ReuTheCoder/bolide-65-keeb/cad/readme.md

# CAD Notes

* To find the `.step` file for each individual component, look in the `production` folder.
    * Most 3D models came from KiCad's default libraries. Anythig else came from [GrabCAD](https://grabcad.com/library/cherry-mx-stabilizer-mx-1) or the [scottokeebs](https://github.com/joe-scotto/scottokeebs/tree/main/Extras/ScottoKicad/3dmodels) Github.

* The `.json` file was used to generate the top plate using the [ai03 Plate Generator](https://kbplate.ai03.com/).

* The source design can be found [here](https://cad.onshape.com/documents/e99e54822f92a5f5925595cc/w/6180f1e1b18eeb4808e4ffdc/e/0a846f45fd57540ab5465ead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).
