ReuTheCoder/bolide-65-keeb/assets/readme/bolide-CAD_quote.png

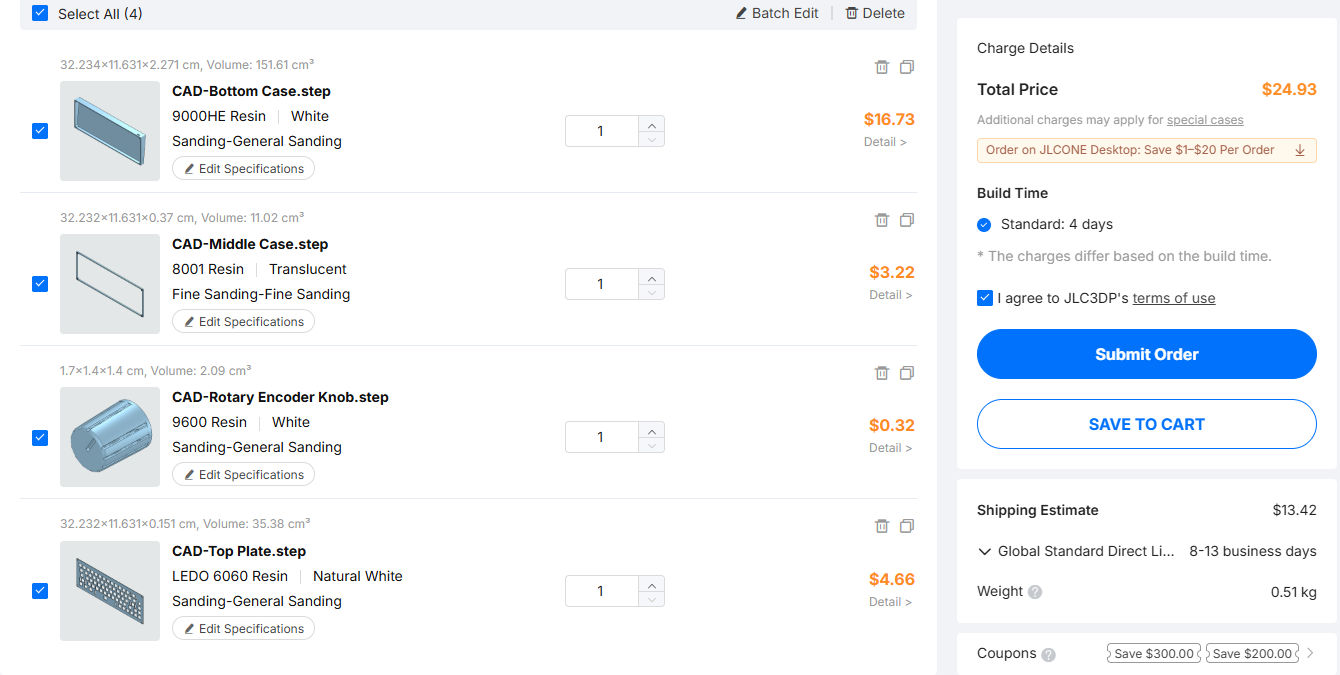
assets/readme/bolide-CAD_quote.png
