ReuTheCoder/bolide-65-keeb/assets/readme/bolide-pcb_quote.png

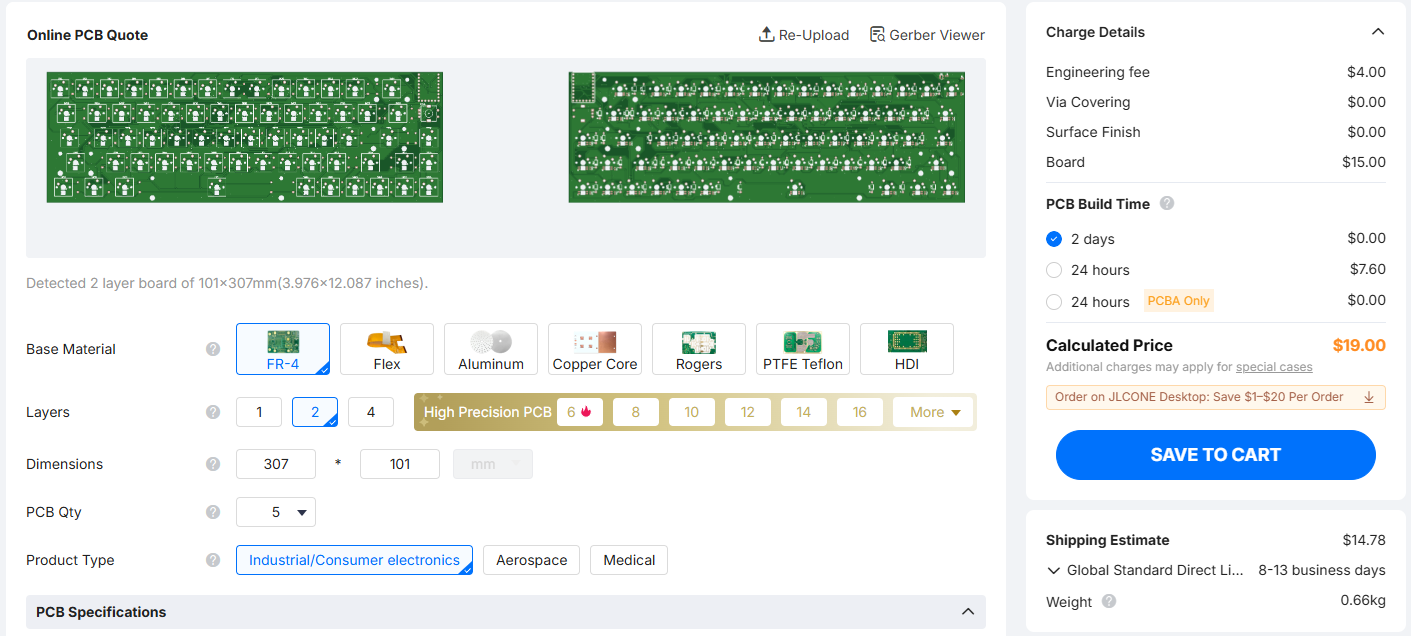
assets/readme/bolide-pcb_quote.png
