ReuTheCoder/bolide-65-keeb/bom.csv

Item Name | Qty | Price (total) (USD) | Item link | Notes
330 Ω 0603 resistor [Uni-Royal 0603WAF3300T5E] | 100 | $0.26 | https://www.lcsc.com/product-detail/Chip-Resistor-Surface-Mount_UNI-ROYAL-Uniroyal-Elec-0603WAF3300T5E_C23138.html | Must purchase 100 in order to source the 1 resistor needed. Purpose: To protect LED backlights and ensure stable signal transmission.
0.1 µF Ceramic Capacitors [Samsung Electro-Mechanics CL10B104KB8NNNC] | 100 | $0.79 | https://www.lcsc.com/product-detail/C1591.html | Must purchase 100 in order to source the 67 capacitors needed. Purpose: to smooth out power fluctuations and subsequently prevent LEDs from glitching or resetting
74AHCT1G125 Level Shifter [TI SN74AHCT1G125DBVR] | 5 | $0.50 | https://www.lcsc.com/product-detail/C7484.html | Must purchase 5 in order to source the 1 level shifter needed. Purpose: To translate the low 3V3 voltage data from the RP2040 Zero to the higher level required by the LEDs
Fast Switching Diode [Changzhou Starsea Elec 1N4148] | 100 | $1.34 | https://www.lcsc.com/product-detail/C85057.html | Must purchase 100 in order to source the 67 diodes needed. Purpose: Used in matrix wiring to prevent ghosting from keyboard
SK6812 MINI-E Addressable LEDs | 70 | $4.56 | https://www.lcsc.com/product-detail/Light-Emitting-Diodes-LED_OPSCO-Optoelectronics-SK6812MINI-E_C5149201.html | Must purchase 70 in order to source the 66 diodes needed. Purpose: To add programmable backlight to keyboard
PCB | 1 | $19.00 | https://github.com/ReuTheCoder/bolide-65-keeb/blob/main/assets/bolide-pcb_quote.png | Uses default PCB settings on JLCPCB
Womier Pudding Keycaps, Black PBT Shine Through (130 Keycap Set) | 1 | $12.61 | https://www.amazon.ca/Womier-Pudding-Keyboard-Switches-Keyboard-Black/dp/B0D4DN5HK1 | Keycap choice is not mandatory. Can choose other keycap set; see through recommended
PCB Mount Screw In Stabilizers (1x 6.25u, 4x 2u) | 1 | $4.72 | https://www.amazon.ca/Mechanical-Keyboard-Stabilizers-Stabilizer-Backlight/dp/B0GS7HQJP6 | Stabilizer choice is not mandatory.. Can choose other screw in stabilizer set
Glorious Fox Linear Mechanical Switches (110 pcs) | 1 | $23.09 | https://www.amazon.ca/Glorious-Linear-Mechanical-Switches-Keyboards/dp/B0D7QW8SQ9 | Switch choice is not mandatory. Can choose other MX-style switch
Waveshare RP2040 Zero | 1 | $4.20 | https://ca.robotshop.com/products/rp2040-zero-pico-like-mcu-board-based-on-rp2040-mini-version-w-o-header | Ensure you have pin headers
EC11 Rotary Encoder | 1 | $2.22 | https://www.lcsc.com/product-detail/C202365.html&ref=https%3A%2F%2Fwww.lcsc.com%2Fproduct-detail%2FC202365.html | CAD files have custom knob
Bottom Case | 1 | $16.73 | https://github.com/ReuTheCoder/bolide-65-keeb/blob/main/assets/readme/bolide-CAD_quote.png | Uses 9000HE Resin
Middle Case | 1 | $3.22 | https://github.com/ReuTheCoder/bolide-65-keeb/blob/main/assets/readme/bolide-CAD_quote.png | Uses Translucent 8001 Resin
Top Plate | 1 | $4.66 | https://github.com/ReuTheCoder/bolide-65-keeb/blob/main/assets/readme/bolide-CAD_quote.png | Uses LEDO 6060 Resin (too thin for 9600HE)
Rotary Encoder Knob | 1 | $0.32 | https://github.com/ReuTheCoder/bolide-65-keeb/blob/main/assets/readme/bolide-CAD_quote.png | Uses 9600 Resin
M3x16mm screws | 4 | $8.69 | https://www.amazon.ca/uxcell-M3x16mm-Alloy-Socket-Screws/dp/B012T9FWEI | Price is only for 12 screws; likely better price at local stores
M3x5mmx4mm Heatset Inserts | 4 | $7.69 | https://www.aliexpress.com/item/4000232858343.html?gatewayAdapt=usa2glo4itemAdapt | Price is for 100pcs
Total Price (USD): | $114.60
