ReuTheCoder/bolide-65-keeb/production/CAD-Bottom Case.step

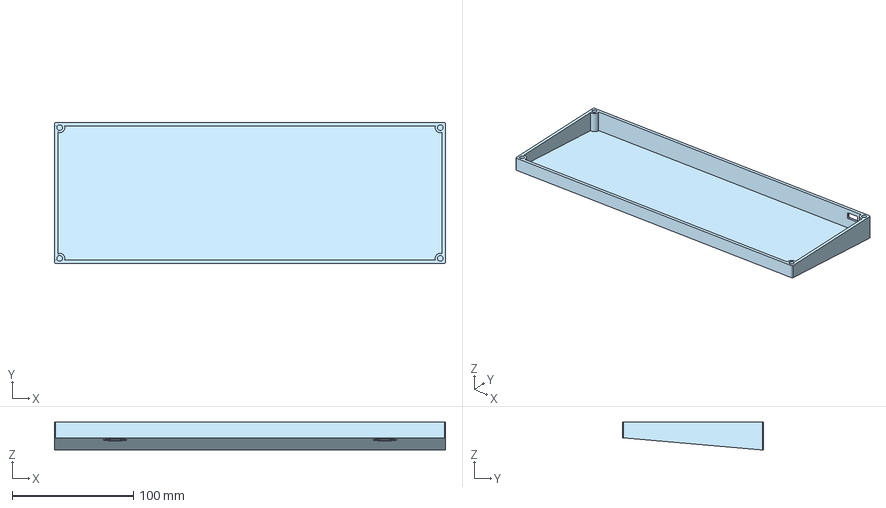
[picture p11: CAD file, 2026-10-22]
production/CAD-Bottom Case.step
322.3 x 116.3 x 22.7 mm
