ReuTheCoder/bolide-65-keeb/production/CAD-Rotary Encoder Knob.step

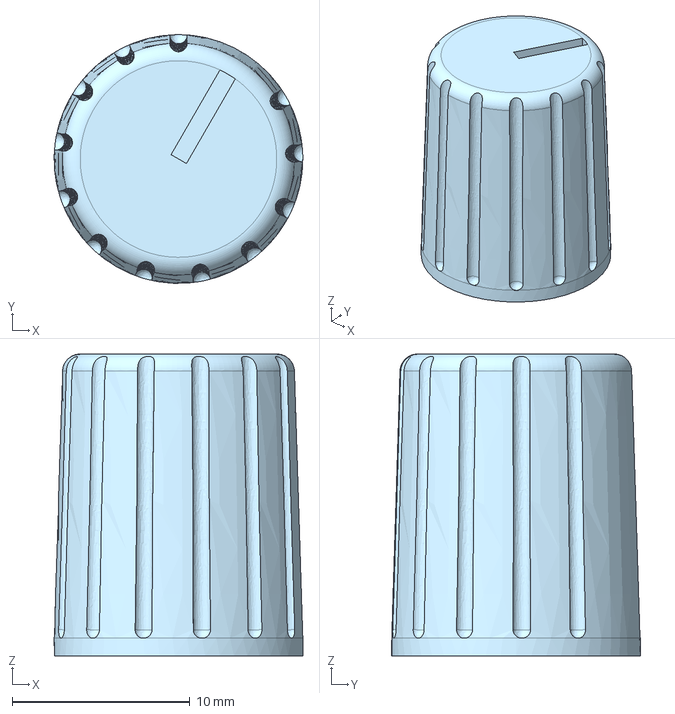
[picture p12: CAD file, 2026-10-22]
production/CAD-Rotary Encoder Knob.step
14.0 x 14.0 x 17.0 mm
