ReuTheCoder/bolide-65-keeb/production/CAD-Middle Case.step

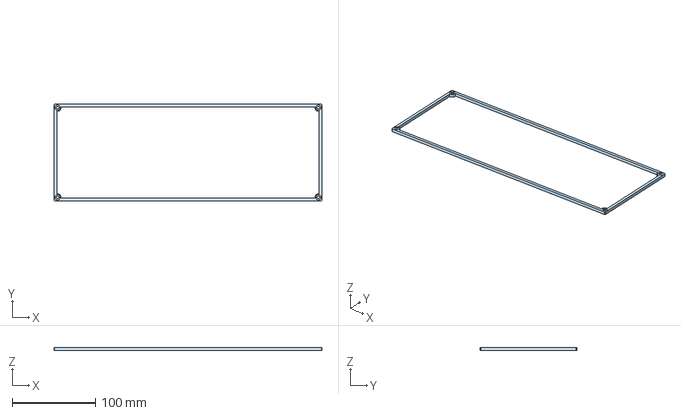
[picture p13: CAD file, 2026-10-22]
production/CAD-Middle Case.step
322.3 x 116.3 x 3.70 mm
