ReuTheCoder/bolide-65-keeb/production/CAD-Top Plate.step

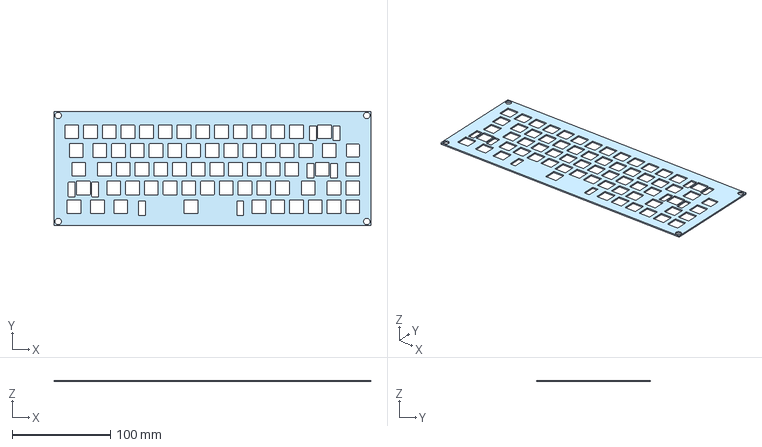
[picture p14: CAD file, 2026-10-22]
production/CAD-Top Plate.step
322.3 x 116.3 x 1.51 mm
