ReuTheCoder/bolide-65-keeb/assets/journal/bolide65-pcb.png

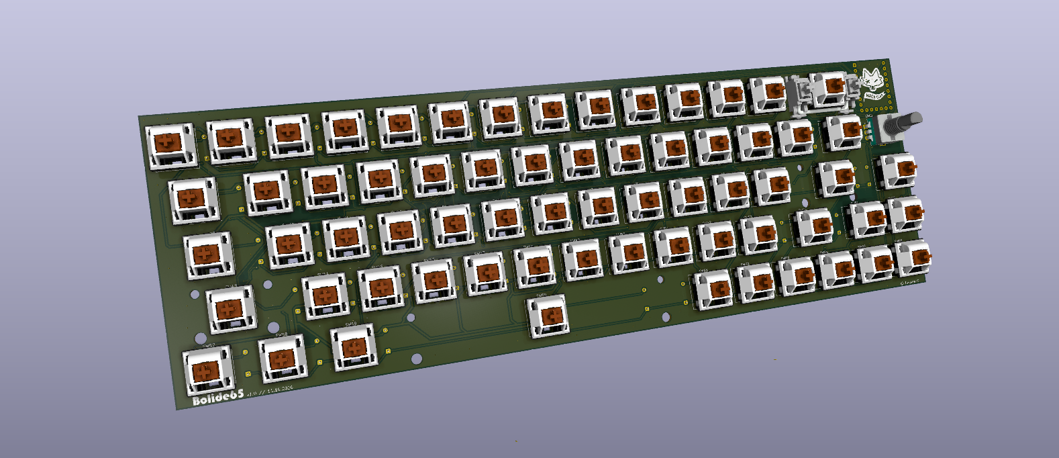
assets/journal/bolide65-pcb.png
