ReuTheCoder/bolide-65-keeb/pcb/bolide-65-pcb.kicad_pcb

## KiCad design pcb/bolide-65-pcb.kicad_pcb (2026-10-18)

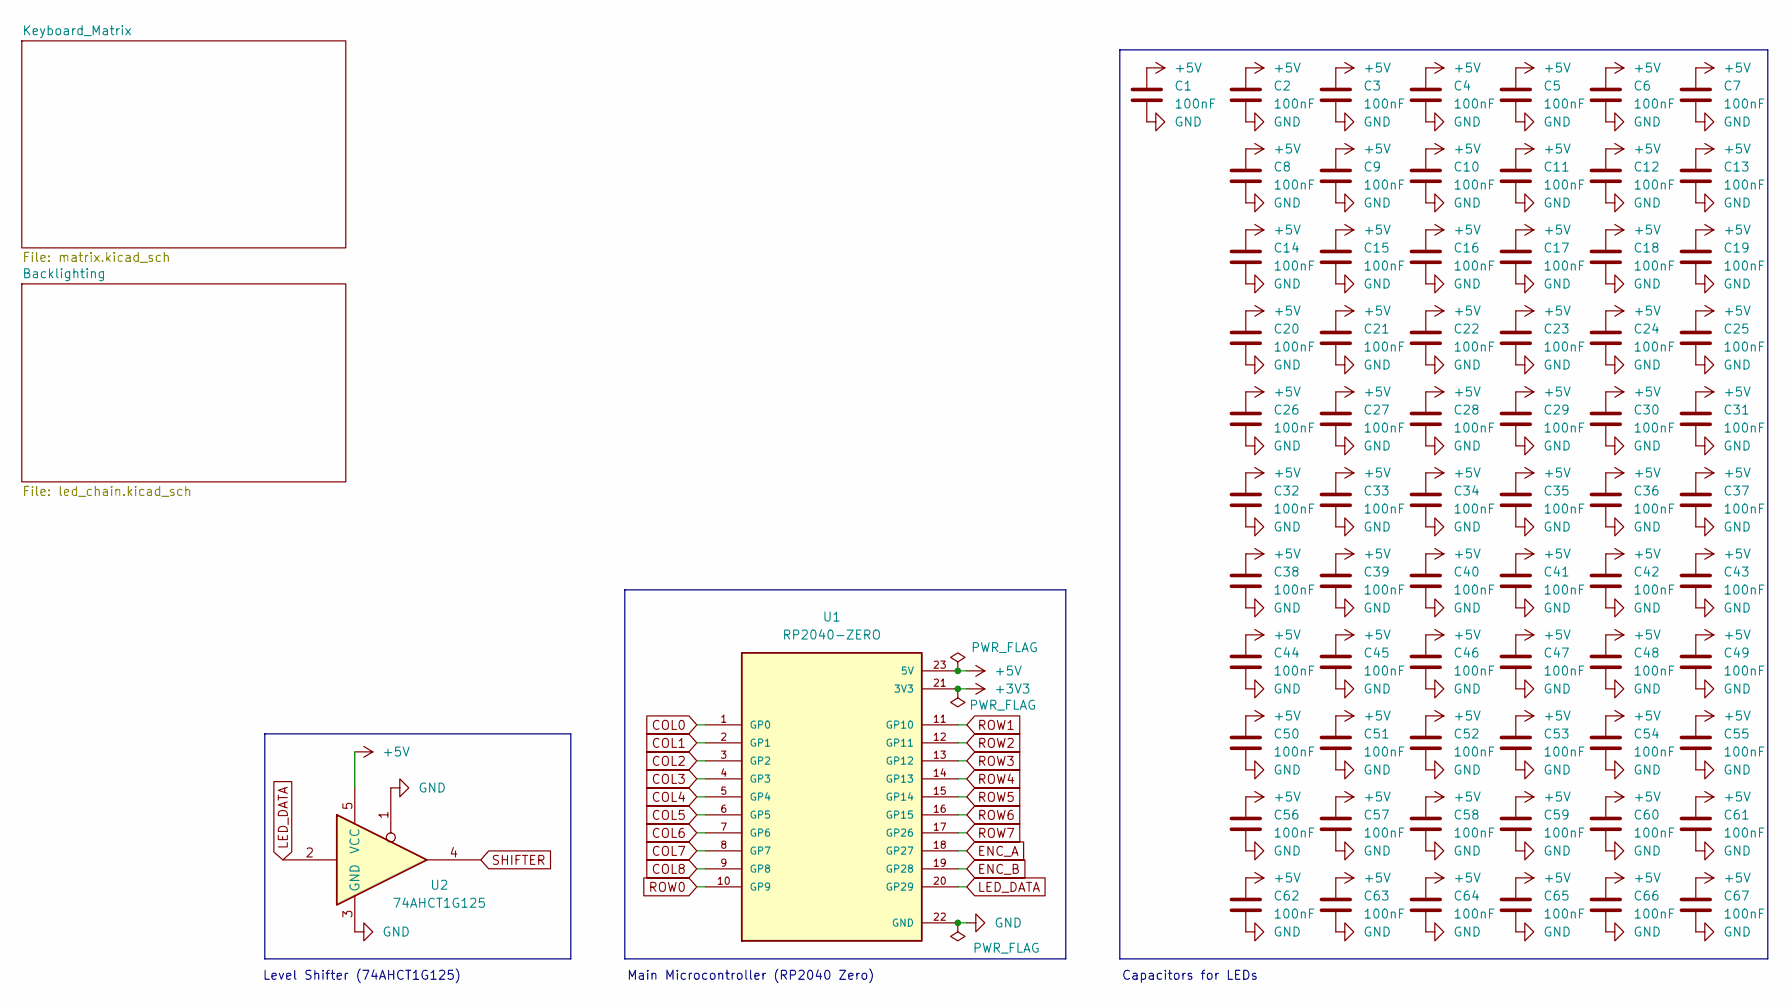
[picture p38: schematic bolide-65-pcb.kicad_sch, Electrical Components for Bolide65 Keyboard]

Parts:
C1, C2, C3, C4, C5, C6, C7, C8, C9, C10, C11, C12, C13, C14, C15, C16, C17, C18, C19, C20, C21, C22, C23, C24, C25, C26, C27, C28, C29, C30, C31, C32, C33, C34, C35, C36, C37, C38, C39, C40, C41, C42, C43, C44, C45, C46, C47, C48, C49, C50, C51, C52, C53, C54, C55, C56, C57, C58, C59, C60, C61, C62, C63, C64, C65, C66, C67: 100nF; C_0603_1608Metric
U1: RP2040-ZERO; MODULE_RP2040-ZERO; PARTREV NA
U2: 74AHCT1G125; SOT-23-5

Connections:
+3V3: U1.21 (3V3)
+5V: C1.1, C2.1, C3.1, C4.1, C5.1, C6.1, C7.1, C8.1, C9.1, C10.1, C11.1, C12.1, C13.1, C14.1, C15.1, C16.1, C17.1, C18.1, C19.1, C20.1, C21.1, C22.1, C23.1, C24.1, C25.1, C26.1, C27.1, C28.1, C29.1, C30.1, C31.1, C32.1, C33.1, C34.1, C35.1, C36.1, C37.1, C38.1, C39.1, C40.1, C41.1, C42.1, C43.1, C44.1, C45.1, C46.1, C47.1, C48.1, C49.1, C50.1, C51.1, C52.1, C53.1, C54.1, C55.1, C56.1, C57.1, C58.1, C59.1, C60.1, C61.1, C62.1, C63.1, C64.1, C65.1, C66.1, C67.1, U1.23 (5V), U2.5 (VCC); also elsewhere on the board
COL0: U1.1 (GP0); also elsewhere on the board
COL1: U1.2 (GP1); also elsewhere on the board
COL2: U1.3 (GP2); also elsewhere on the board
COL3: U1.4 (GP3); also elsewhere on the board
COL4: U1.5 (GP4); also elsewhere on the board
COL5: U1.6 (GP5); also elsewhere on the board
COL6: U1.7 (GP6); also elsewhere on the board
COL7: U1.8 (GP7); also elsewhere on the board
COL8: U1.9 (GP8); also elsewhere on the board
ENC_A: U1.18 (GP27); also elsewhere on the board
ENC_B: U1.19 (GP28); also elsewhere on the board
GND: C1.2, C2.2, C3.2, C4.2, C5.2, C6.2, C7.2, C8.2, C9.2, C10.2, C11.2, C12.2, C13.2, C14.2, C15.2, C16.2, C17.2, C18.2, C19.2, C20.2, C21.2, C22.2, C23.2, C24.2, C25.2, C26.2, C27.2, C28.2, C29.2, C30.2, C31.2, C32.2, C33.2, C34.2, C35.2, C36.2, C37.2, C38.2, C39.2, C40.2, C41.2, C42.2, C43.2, C44.2, C45.2, C46.2, C47.2, C48.2, C49.2, C50.2, C51.2, C52.2, C53.2, C54.2, C55.2, C56.2, C57.2, C58.2, C59.2, C60.2, C61.2, C62.2, C63.2, C64.2, C65.2, C66.2, C67.2, U1.22 (GND), U2.1, U2.3 (GND); also elsewhere on the board
LED_DATA: U1.20 (GP29), U2.2
ROW0: U1.10 (GP9); also elsewhere on the board
ROW1: U1.11 (GP10); also elsewhere on the board
ROW2: U1.12 (GP11); also elsewhere on the board
ROW3: U1.13 (GP12); also elsewhere on the board
ROW4: U1.14 (GP13); also elsewhere on the board
ROW5: U1.15 (GP14); also elsewhere on the board
ROW6: U1.16 (GP15); also elsewhere on the board
ROW7: U1.17 (GP26); also elsewhere on the board
SHIFTER: U2.4; also elsewhere on the board

Notes on the sheet:
Main Microcontroller (RP2040 Zero)
Capacitors for LEDs
Level Shifter (74AHCT1G125)

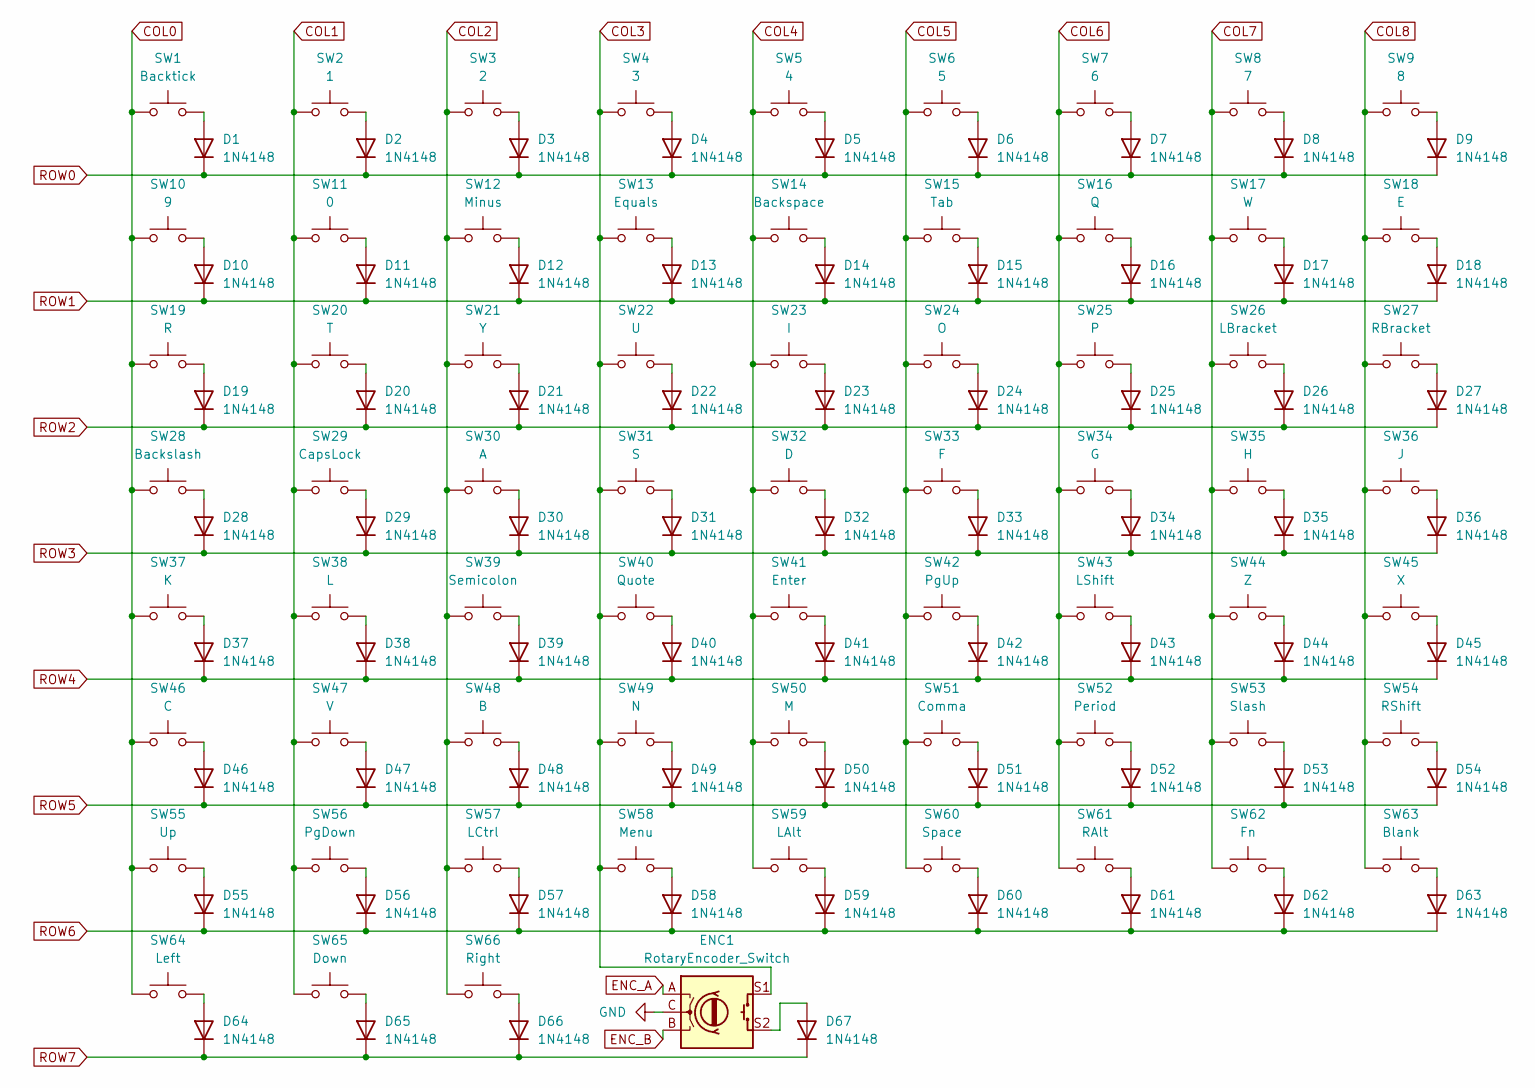
[picture p39: schematic matrix.kicad_sch, Keyboard Matrix]

Parts:
D1, D2, D3, D4, D5, D6, D7, D8, D9, D10, D11, D12, D13, D14, D15, D16, D17, D18, D19, D20, D21, D22, D23, D24, D25, D26, D27, D28, D29, D30, D31, D32, D33, D34, D35, D36, D37, D38, D39, D40, D41, D42, D43, D44, D45, D46, D47, D48, D49, D50, D51, D52, D53, D54, D55, D56, D57, D58, D59, D60, D61, D62, D63, D64, D65, D66, D67: 1N4148; D_DO-35_SOD27_P7.62mm_Horizontal
ENC1: RotaryEncoder_Switch; RotaryEncoder_Alps_EC11E-Switch_Vertical_H20mm
SW1: Backtick; SW_Cherry_MX_1.00u_PCB
SW2: 1; SW_Cherry_MX_1.00u_PCB
SW3: 2; SW_Cherry_MX_1.00u_PCB
SW4: 3; SW_Cherry_MX_1.00u_PCB
SW5: 4; SW_Cherry_MX_1.00u_PCB
SW6: 5; SW_Cherry_MX_1.00u_PCB
SW7: 6; SW_Cherry_MX_1.00u_PCB
SW8: 7; SW_Cherry_MX_1.00u_PCB
SW9: 8; SW_Cherry_MX_1.00u_PCB
SW10: 9; SW_Cherry_MX_1.00u_PCB
SW11: 0; SW_Cherry_MX_1.00u_PCB
SW12: Minus; SW_Cherry_MX_1.00u_PCB
SW13: Equals; SW_Cherry_MX_1.00u_PCB
SW14: Backspace; SW_Cherry_MX_2.00u_PCB
SW15: Tab; SW_Cherry_MX_1.50u_PCB
SW16: Q; SW_Cherry_MX_1.00u_PCB
SW17: W; SW_Cherry_MX_1.00u_PCB
SW18: E; SW_Cherry_MX_1.00u_PCB
SW19: R; SW_Cherry_MX_1.00u_PCB
SW20: T; SW_Cherry_MX_1.00u_PCB
SW21: Y; SW_Cherry_MX_1.00u_PCB
SW22: U; SW_Cherry_MX_1.00u_PCB
SW23: I; SW_Cherry_MX_1.00u_PCB
SW24: O; SW_Cherry_MX_1.00u_PCB
SW25: P; SW_Cherry_MX_1.00u_PCB
SW26: LBracket; SW_Cherry_MX_1.00u_PCB
SW27: RBracket; SW_Cherry_MX_1.00u_PCB
SW28: Backslash; SW_Cherry_MX_1.50u_PCB
SW29: CapsLock; SW_Cherry_MX_1.75u_PCB
SW30: A; SW_Cherry_MX_1.00u_PCB
SW31: S; SW_Cherry_MX_1.00u_PCB
SW32: D; SW_Cherry_MX_1.00u_PCB
SW33: F; SW_Cherry_MX_1.00u_PCB
SW34: G; SW_Cherry_MX_1.00u_PCB
SW35: H; SW_Cherry_MX_1.00u_PCB
SW36: J; SW_Cherry_MX_1.00u_PCB
SW37: K; SW_Cherry_MX_1.00u_PCB
SW38: L; SW_Cherry_MX_1.00u_PCB
SW39: Semicolon; SW_Cherry_MX_1.00u_PCB
SW40: Quote; SW_Cherry_MX_1.00u_PCB
SW41: Enter; SW_Cherry_MX_2.25u_PCB
SW42: PgUp; SW_Cherry_MX_1.00u_PCB
SW43: LShift; SW_Cherry_MX_2.25u_PCB
SW44: Z; SW_Cherry_MX_1.00u_PCB
SW45: X; SW_Cherry_MX_1.00u_PCB
SW46: C; SW_Cherry_MX_1.00u_PCB
SW47: V; SW_Cherry_MX_1.00u_PCB
SW48: B; SW_Cherry_MX_1.00u_PCB
SW49: N; SW_Cherry_MX_1.00u_PCB
SW50: M; SW_Cherry_MX_1.00u_PCB
SW51: Comma; SW_Cherry_MX_1.00u_PCB
SW52: Period; SW_Cherry_MX_1.00u_PCB
SW53: Slash; SW_Cherry_MX_1.00u_PCB
SW54: RShift; SW_Cherry_MX_1.75u_PCB
SW55: Up; SW_Cherry_MX_1.00u_PCB
SW56: PgDown; SW_Cherry_MX_1.00u_PCB
SW57: LCtrl; SW_Cherry_MX_1.25u_PCB
SW58: Menu; SW_Cherry_MX_1.25u_PCB
SW59: LAlt; SW_Cherry_MX_1.25u_PCB
SW60: Space; SW_Cherry_MX_6.25u_PCB
SW61: RAlt; SW_Cherry_MX_1.00u_PCB
SW62: Fn; SW_Cherry_MX_1.00u_PCB
SW63: Blank; SW_Cherry_MX_1.00u_PCB
SW64: Left; SW_Cherry_MX_1.00u_PCB
SW65: Down; SW_Cherry_MX_1.00u_PCB
SW66: Right; SW_Cherry_MX_1.00u_PCB

Connections:
COL0: SW1.1, SW10.1, SW19.1, SW28.1, SW37.1, SW46.1, SW55.1, SW64.1; also elsewhere on the board
COL1: SW2.1, SW11.1, SW20.1, SW29.1, SW38.1, SW47.1, SW56.1, SW65.1; also elsewhere on the board
COL2: SW3.1, SW12.1, SW21.1, SW30.1, SW39.1, SW48.1, SW57.1, SW66.1; also elsewhere on the board
COL3: ENC1.S1, SW4.1, SW13.1, SW22.1, SW31.1, SW40.1, SW49.1, SW58.1; also elsewhere on the board
COL4: SW5.1, SW14.1, SW23.1, SW32.1, SW41.1, SW50.1, SW59.1; also elsewhere on the board
COL5: SW6.1, SW15.1, SW24.1, SW33.1, SW42.1, SW51.1, SW60.1; also elsewhere on the board
COL6: SW7.1, SW16.1, SW25.1, SW34.1, SW43.1, SW52.1, SW61.1; also elsewhere on the board
COL7: SW8.1, SW17.1, SW26.1, SW35.1, SW44.1, SW53.1, SW62.1; also elsewhere on the board
COL8: SW9.1, SW18.1, SW27.1, SW36.1, SW45.1, SW54.1, SW63.1; also elsewhere on the board
ENC_A: ENC1.A; also elsewhere on the board
ENC_B: ENC1.B; also elsewhere on the board
GND: ENC1.C; also elsewhere on the board
unnamed: D1.2 (A), SW1.2
unnamed: D2.2 (A), SW2.2
unnamed: D3.2 (A), SW3.2
unnamed: D4.2 (A), SW4.2
unnamed: D5.2 (A), SW5.2
unnamed: D6.2 (A), SW6.2
unnamed: D7.2 (A), SW7.2
unnamed: D8.2 (A), SW8.2
unnamed: D9.2 (A), SW9.2
unnamed: D10.2 (A), SW10.2
unnamed: D11.2 (A), SW11.2
unnamed: D12.2 (A), SW12.2
unnamed: D13.2 (A), SW13.2
unnamed: D14.2 (A), SW14.2
unnamed: D15.2 (A), SW15.2
unnamed: D16.2 (A), SW16.2
unnamed: D17.2 (A), SW17.2
unnamed: D18.2 (A), SW18.2
unnamed: D19.2 (A), SW19.2
unnamed: D20.2 (A), SW20.2
unnamed: D21.2 (A), SW21.2
unnamed: D22.2 (A), SW22.2
unnamed: D23.2 (A), SW23.2
unnamed: D24.2 (A), SW24.2
unnamed: D25.2 (A), SW25.2
unnamed: D26.2 (A), SW26.2
unnamed: D27.2 (A), SW27.2
unnamed: D28.2 (A), SW28.2
unnamed: D29.2 (A), SW29.2
unnamed: D30.2 (A), SW30.2
unnamed: D31.2 (A), SW31.2
unnamed: D32.2 (A), SW32.2
unnamed: D33.2 (A), SW33.2
unnamed: D34.2 (A), SW34.2
unnamed: D35.2 (A), SW35.2
unnamed: D36.2 (A), SW36.2
unnamed: D37.2 (A), SW37.2
unnamed: D38.2 (A), SW38.2
unnamed: D39.2 (A), SW39.2
unnamed: D40.2 (A), SW40.2
unnamed: D41.2 (A), SW41.2
unnamed: D42.2 (A), SW42.2
unnamed: D43.2 (A), SW43.2
unnamed: D44.2 (A), SW44.2
unnamed: D45.2 (A), SW45.2
unnamed: D46.2 (A), SW46.2
unnamed: D47.2 (A), SW47.2
unnamed: D48.2 (A), SW48.2
unnamed: D49.2 (A), SW49.2
unnamed: D50.2 (A), SW50.2
unnamed: D51.2 (A), SW51.2
unnamed: D52.2 (A), SW52.2
unnamed: D53.2 (A), SW53.2
unnamed: D54.2 (A), SW54.2
unnamed: D55.2 (A), SW55.2
unnamed: D56.2 (A), SW56.2
unnamed: D57.2 (A), SW57.2
unnamed: D58.2 (A), SW58.2
unnamed: D59.2 (A), SW59.2
unnamed: D60.2 (A), SW60.2
unnamed: D61.2 (A), SW61.2
unnamed: D62.2 (A), SW62.2
unnamed: D63.2 (A), SW63.2
unnamed: D64.2 (A), SW64.2
unnamed: D65.2 (A), SW65.2
unnamed: D66.2 (A), SW66.2
unnamed: D67.2 (A), ENC1.S2
ROW0: D1.1 (K), D2.1 (K), D3.1 (K), D4.1 (K), D5.1 (K), D6.1 (K), D7.1 (K), D8.1 (K), D9.1 (K); also elsewhere on the board
ROW1: D10.1 (K), D11.1 (K), D12.1 (K), D13.1 (K), D14.1 (K), D15.1 (K), D16.1 (K), D17.1 (K), D18.1 (K); also elsewhere on the board
ROW2: D19.1 (K), D20.1 (K), D21.1 (K), D22.1 (K), D23.1 (K), D24.1 (K), D25.1 (K), D26.1 (K), D27.1 (K); also elsewhere on the board
ROW3: D28.1 (K), D29.1 (K), D30.1 (K), D31.1 (K), D32.1 (K), D33.1 (K), D34.1 (K), D35.1 (K), D36.1 (K); also elsewhere on the board
ROW4: D37.1 (K), D38.1 (K), D39.1 (K), D40.1 (K), D41.1 (K), D42.1 (K), D43.1 (K), D44.1 (K), D45.1 (K); also elsewhere on the board
ROW5: D46.1 (K), D47.1 (K), D48.1 (K), D49.1 (K), D50.1 (K), D51.1 (K), D52.1 (K), D53.1 (K), D54.1 (K); also elsewhere on the board
ROW6: D55.1 (K), D56.1 (K), D57.1 (K), D58.1 (K), D59.1 (K), D60.1 (K), D61.1 (K), D62.1 (K), D63.1 (K); also elsewhere on the board
ROW7: D64.1 (K), D65.1 (K), D66.1 (K), D67.1 (K); also elsewhere on the board

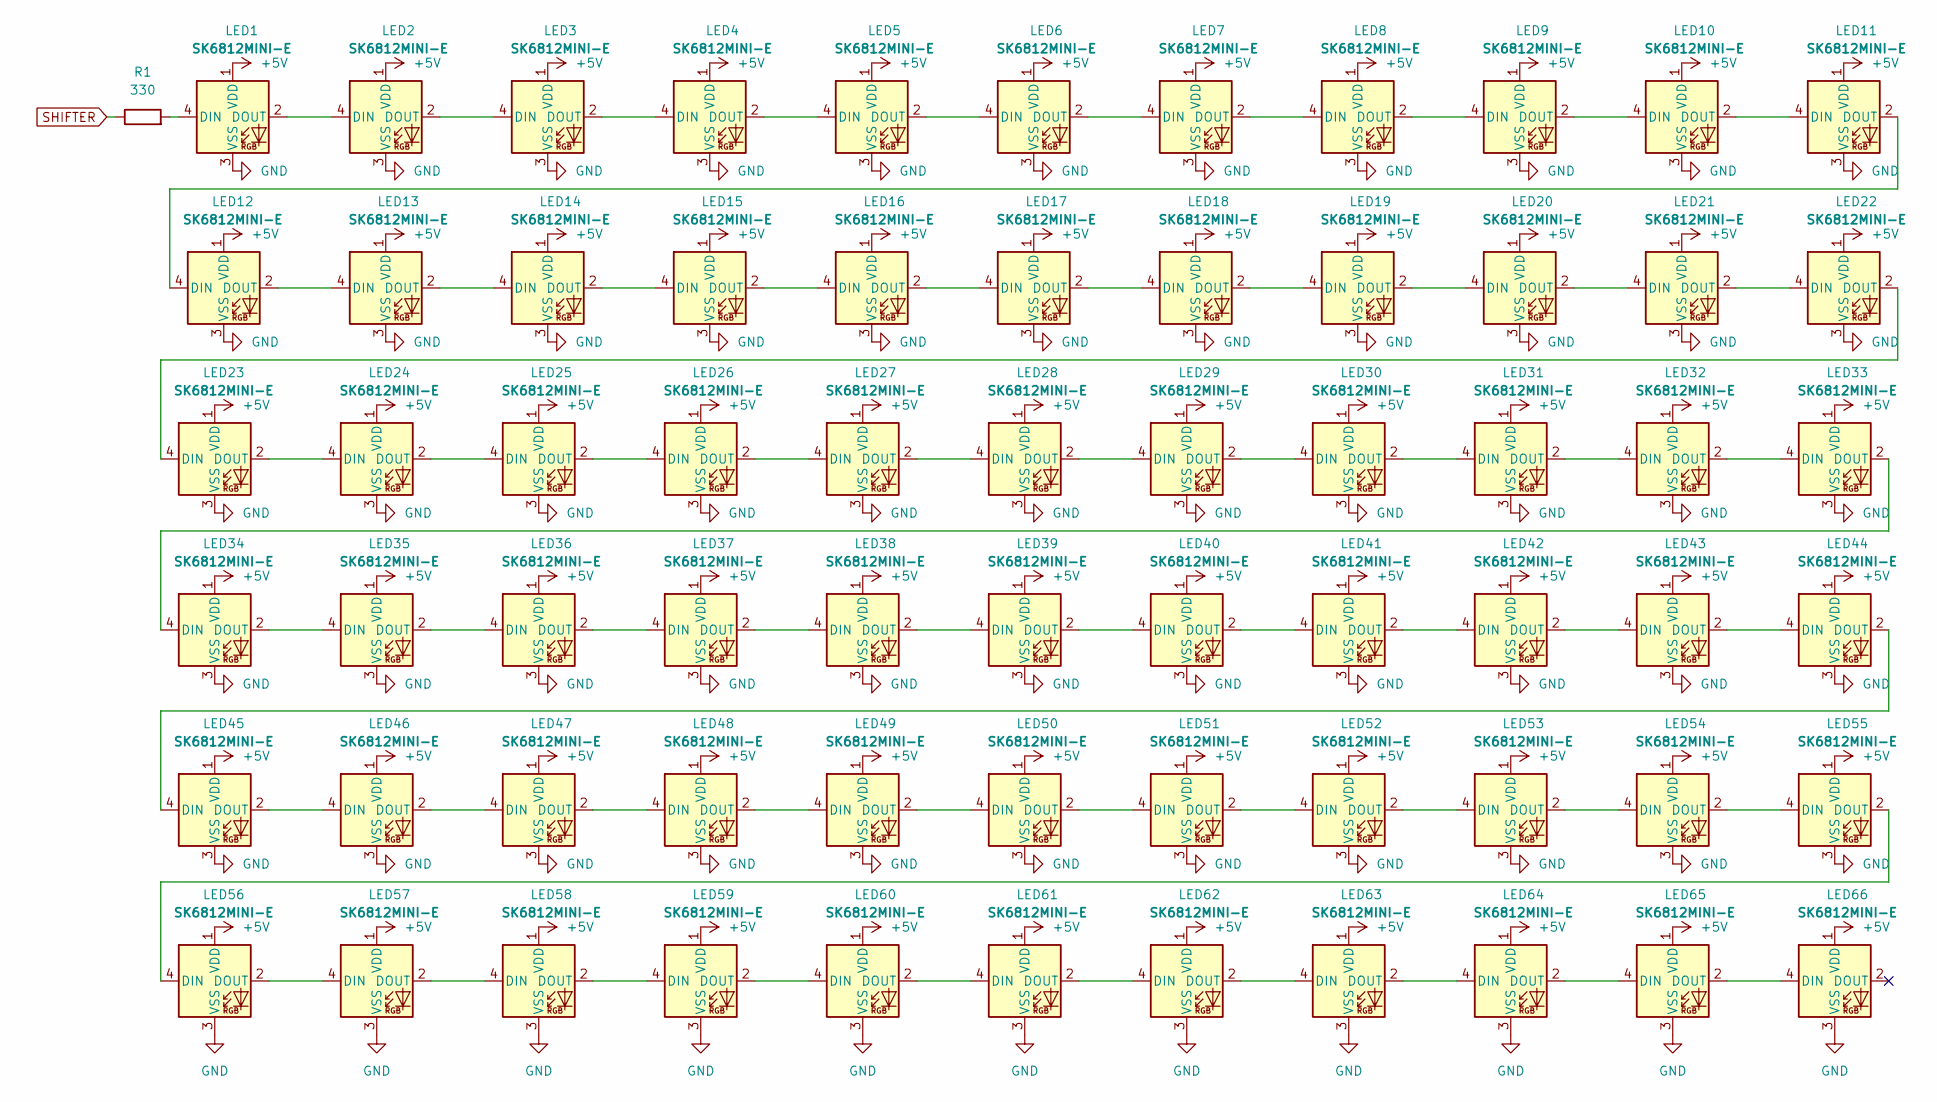
[picture p40: schematic led_chain.kicad_sch, Data Chian for LED Backlighting]

Parts:
LED1, LED2, LED3, LED4, LED5, LED6, LED7, LED8, LED9, LED10, LED11, LED12, LED13, LED14, LED15, LED16, LED17, LED18, LED19, LED20, LED21, LED22, LED23, LED24, LED25, LED26, LED27, LED28, LED29, LED30, LED31, LED32, LED33, LED34, LED35, LED36, LED37, LED38, LED39, LED40, LED41, LED42, LED43, LED44, LED45, LED46, LED47, LED48, LED49, LED50, LED51, LED52, LED53, LED54, LED55, LED56, LED57, LED58, LED59, LED60, LED61, LED62, LED63, LED64, LED65, LED66: SK6812MINI-E; SK6812MINI-E_fixed
R1: 330; R_0603_1608Metric

Connections:
+5V: LED1.1 (VDD), LED2.1 (VDD), LED3.1 (VDD), LED4.1 (VDD), LED5.1 (VDD), LED6.1 (VDD), LED7.1 (VDD), LED8.1 (VDD), LED9.1 (VDD), LED10.1 (VDD), LED11.1 (VDD), LED12.1 (VDD), LED13.1 (VDD), LED14.1 (VDD), LED15.1 (VDD), LED16.1 (VDD), LED17.1 (VDD), LED18.1 (VDD), LED19.1 (VDD), LED20.1 (VDD), LED21.1 (VDD), LED22.1 (VDD), LED23.1 (VDD), LED24.1 (VDD), LED25.1 (VDD), LED26.1 (VDD), LED27.1 (VDD), LED28.1 (VDD), LED29.1 (VDD), LED30.1 (VDD), LED31.1 (VDD), LED32.1 (VDD), LED33.1 (VDD), LED34.1 (VDD), LED35.1 (VDD), LED36.1 (VDD), LED37.1 (VDD), LED38.1 (VDD), LED39.1 (VDD), LED40.1 (VDD), LED41.1 (VDD), LED42.1 (VDD), LED43.1 (VDD), LED44.1 (VDD), LED45.1 (VDD), LED46.1 (VDD), LED47.1 (VDD), LED48.1 (VDD), LED49.1 (VDD), LED50.1 (VDD), LED51.1 (VDD), LED52.1 (VDD), LED53.1 (VDD), LED54.1 (VDD), LED55.1 (VDD), LED56.1 (VDD), LED57.1 (VDD), LED58.1 (VDD), LED59.1 (VDD), LED60.1 (VDD), LED61.1 (VDD), LED62.1 (VDD), LED63.1 (VDD), LED64.1 (VDD), LED65.1 (VDD), LED66.1 (VDD); also elsewhere on the board
GND: LED1.3 (VSS), LED2.3 (VSS), LED3.3 (VSS), LED4.3 (VSS), LED5.3 (VSS), LED6.3 (VSS), LED7.3 (VSS), LED8.3 (VSS), LED9.3 (VSS), LED10.3 (VSS), LED11.3 (VSS), LED12.3 (VSS), LED13.3 (VSS), LED14.3 (VSS), LED15.3 (VSS), LED16.3 (VSS), LED17.3 (VSS), LED18.3 (VSS), LED19.3 (VSS), LED20.3 (VSS), LED21.3 (VSS), LED22.3 (VSS), LED23.3 (VSS), LED24.3 (VSS), LED25.3 (VSS), LED26.3 (VSS), LED27.3 (VSS), LED28.3 (VSS), LED29.3 (VSS), LED30.3 (VSS), LED31.3 (VSS), LED32.3 (VSS), LED33.3 (VSS), LED34.3 (VSS), LED35.3 (VSS), LED36.3 (VSS), LED37.3 (VSS), LED38.3 (VSS), LED39.3 (VSS), LED40.3 (VSS), LED41.3 (VSS), LED42.3 (VSS), LED43.3 (VSS), LED44.3 (VSS), LED45.3 (VSS), LED46.3 (VSS), LED47.3 (VSS), LED48.3 (VSS), LED49.3 (VSS), LED50.3 (VSS), LED51.3 (VSS), LED52.3 (VSS), LED53.3 (VSS), LED54.3 (VSS), LED55.3 (VSS), LED56.3 (VSS), LED57.3 (VSS), LED58.3 (VSS), LED59.3 (VSS), LED60.3 (VSS), LED61.3 (VSS), LED62.3 (VSS), LED63.3 (VSS), LED64.3 (VSS), LED65.3 (VSS), LED66.3 (VSS); also elsewhere on the board
unnamed: LED1.4 (DIN), R1.2
unnamed: LED1.2 (DOUT), LED2.4 (DIN)
unnamed: LED2.2 (DOUT), LED3.4 (DIN)
unnamed: LED3.2 (DOUT), LED4.4 (DIN)
unnamed: LED4.2 (DOUT), LED5.4 (DIN)
unnamed: LED5.2 (DOUT), LED6.4 (DIN)
unnamed: LED6.2 (DOUT), LED7.4 (DIN)
unnamed: LED7.2 (DOUT), LED8.4 (DIN)
unnamed: LED8.2 (DOUT), LED9.4 (DIN)
unnamed: LED9.2 (DOUT), LED10.4 (DIN)
unnamed: LED10.2 (DOUT), LED11.4 (DIN)
unnamed: LED11.2 (DOUT), LED12.4 (DIN)
unnamed: LED12.2 (DOUT), LED13.4 (DIN)
unnamed: LED13.2 (DOUT), LED14.4 (DIN)
unnamed: LED14.2 (DOUT), LED15.4 (DIN)
unnamed: LED15.2 (DOUT), LED16.4 (DIN)
unnamed: LED16.2 (DOUT), LED17.4 (DIN)
unnamed: LED17.2 (DOUT), LED18.4 (DIN)
unnamed: LED18.2 (DOUT), LED19.4 (DIN)
unnamed: LED19.2 (DOUT), LED20.4 (DIN)
unnamed: LED20.2 (DOUT), LED21.4 (DIN)
unnamed: LED21.2 (DOUT), LED22.4 (DIN)
unnamed: LED22.2 (DOUT), LED23.4 (DIN)
unnamed: LED23.2 (DOUT), LED24.4 (DIN)
unnamed: LED24.2 (DOUT), LED25.4 (DIN)
unnamed: LED25.2 (DOUT), LED26.4 (DIN)
unnamed: LED26.2 (DOUT), LED27.4 (DIN)
unnamed: LED27.2 (DOUT), LED28.4 (DIN)
unnamed: LED28.2 (DOUT), LED29.4 (DIN)
unnamed: LED29.2 (DOUT), LED30.4 (DIN)
unnamed: LED30.2 (DOUT), LED31.4 (DIN)
unnamed: LED31.2 (DOUT), LED32.4 (DIN)
unnamed: LED32.2 (DOUT), LED33.4 (DIN)
unnamed: LED33.2 (DOUT), LED34.4 (DIN)
unnamed: LED34.2 (DOUT), LED35.4 (DIN)
unnamed: LED35.2 (DOUT), LED36.4 (DIN)
unnamed: LED36.2 (DOUT), LED37.4 (DIN)
unnamed: LED37.2 (DOUT), LED38.4 (DIN)
unnamed: LED38.2 (DOUT), LED39.4 (DIN)
unnamed: LED39.2 (DOUT), LED40.4 (DIN)
unnamed: LED40.2 (DOUT), LED41.4 (DIN)
unnamed: LED41.2 (DOUT), LED42.4 (DIN)
unnamed: LED42.2 (DOUT), LED43.4 (DIN)
unnamed: LED43.2 (DOUT), LED44.4 (DIN)
unnamed: LED44.2 (DOUT), LED45.4 (DIN)
unnamed: LED45.2 (DOUT), LED46.4 (DIN)
unnamed: LED46.2 (DOUT), LED47.4 (DIN)
unnamed: LED47.2 (DOUT), LED48.4 (DIN)
unnamed: LED48.2 (DOUT), LED49.4 (DIN)
unnamed: LED49.2 (DOUT), LED50.4 (DIN)
unnamed: LED50.2 (DOUT), LED51.4 (DIN)
unnamed: LED51.2 (DOUT), LED52.4 (DIN)
unnamed: LED52.2 (DOUT), LED53.4 (DIN)
unnamed: LED53.2 (DOUT), LED54.4 (DIN)
unnamed: LED54.2 (DOUT), LED55.4 (DIN)
unnamed: LED55.2 (DOUT), LED56.4 (DIN)
unnamed: LED56.2 (DOUT), LED57.4 (DIN)
unnamed: LED57.2 (DOUT), LED58.4 (DIN)
unnamed: LED58.2 (DOUT), LED59.4 (DIN)
unnamed: LED59.2 (DOUT), LED60.4 (DIN)
unnamed: LED60.2 (DOUT), LED61.4 (DIN)
unnamed: LED61.2 (DOUT), LED62.4 (DIN)
unnamed: LED62.2 (DOUT), LED63.4 (DIN)
unnamed: LED63.2 (DOUT), LED64.4 (DIN)
unnamed: LED64.2 (DOUT), LED65.4 (DIN)
unnamed: LED65.2 (DOUT), LED66.4 (DIN)
SHIFTER: R1.1; also elsewhere on the board

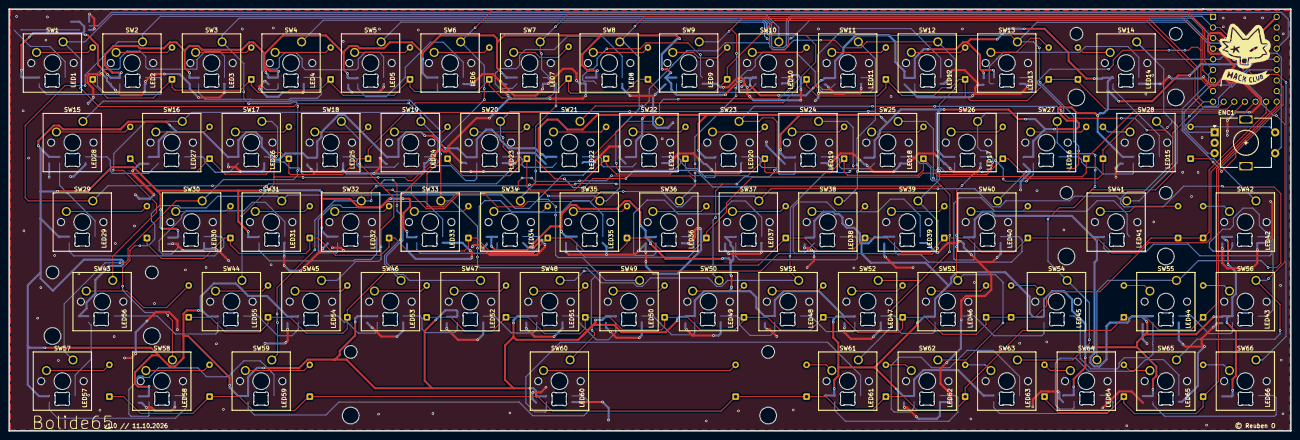
[picture p41: board bolide-65-pcb.kicad_pcb from above]

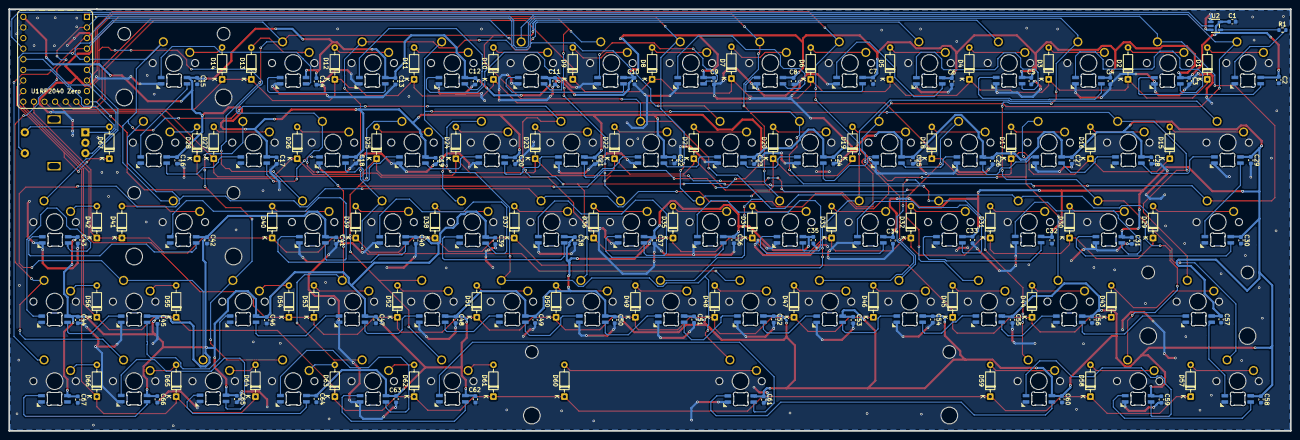
[picture p42: board bolide-65-pcb.kicad_pcb from below]

Board: 2 copper layers, 307.0 x 101.0 mm, 270 parts (137 on the bottom side), 156 nets.
