ReuTheCoder/bolide-65-keeb/firmware/keymaps/default/keymap.c

// Copyright 2026 Reuben O (@ReuTheCoder)
// SPDX-License-Identifier: GPL-2.0-or-later

#include QMK_KEYBOARD_H

//Layer 0 is for normal, Layer 1 is for Function layer

const uint16_t PROGMEM keymaps[][MATRIX_ROWS][MATRIX_COLS] = {
    /*
     * ┌───┬───┬───┬───┬───┬───┬───┬───┬───┬───┬───┬───┬───┬───────┬───┐
     * │Esc│ 1 │ 2 │ 3 │ 4 │ 5 │ 6 │ 7 │ 8 │ 9 │ 0 │ - │ = │ Backsp│
     * ├───┴─┬─┴─┬─┴─┬─┴─┬─┴─┬─┴─┬─┴─┬─┴─┬─┴─┬─┴─┬─┴─┬─┴─┬─┴─┬─────┼───┤
     * │ Tab │ Q │ W │ E │ R │ T │ Y │ U │ I │ O │ P │ [ │ ] │  \  ││
     * ├─────┴┬──┴┬──┴┬──┴┬──┴┬──┴┬──┴┬──┴┬──┴┬──┴┬──┴┬──┴┬──┴─────┼───┤
     * │ Caps │ A │ S │ D │ F │ G │ H │ J │ K │ L │ ; │ ' │  Enter │PgU│
     * ├──────┴─┬─┴─┬─┴─┬─┴─┬─┴─┬─┴─┬─┴─┬─┴─┬─┴─┬─┴─┬─┴─┬─┴────┬───┼───┤
     * │ Shift  │ Z │ X │ C │ V │ B │ N │ M │ , │ . │ / │ Shift│ ↑ │PgD│
     * ├────┬───┴┬──┴─┬─┴───┴───┴───┴───┴───┴──┬┴──┬┴──┬┴──┬───┼───┼───┤
     * │Ctrl│GUI │Alt │                        │Alt│ Fn│___│ ← │ ↓ │ → │
     * └────┴────┴────┴────────────────────────┴───┴───┴───┴───┴───┴───┘
     */
    [0] = LAYOUT_65_custom(
        QK_GESC, KC_1,    KC_2,    KC_3,    KC_4,    KC_5,    KC_6,    KC_7,    KC_8,    KC_9,    KC_0,    KC_MINS, KC_EQL,  KC_BSPC,
        KC_TAB,  KC_Q,    KC_W,    KC_E,    KC_R,    KC_T,    KC_Y,    KC_U,    KC_I,    KC_O,    KC_P,    KC_LBRC, KC_RBRC, KC_BSLS,
        KC_CAPS, KC_A,    KC_S,    KC_D,    KC_F,    KC_G,    KC_H,    KC_J,    KC_K,    KC_L,    KC_SCLN, KC_QUOT,          KC_ENT,  KC_PGUP,
        KC_LSFT,          KC_Z,    KC_X,    KC_C,    KC_V,    KC_B,    KC_N,    KC_M,    KC_COMM, KC_DOT,  KC_SLSH, KC_RSFT, KC_UP,   KC_PGDN,
        KC_LCTL, KC_APP,  KC_LALT,                            KC_SPC,                    KC_RALT, MO(1),   RM_NEXT, KC_LEFT, KC_DOWN, KC_RGHT,
        KC_MUTE
    ),

    /*
     * ┌───┬───┬───┬───┬───┬───┬───┬───┬───┬───┬───┬───┬───┬───────┬───┐
     * │ ` │F1 │F2 │F3 │F4 │F5 │F6 │F7 │F8 │F9 │F10│F11│F12│ Delete│   │
     * ├───┴─┬─┴─┬─┴─┬─┴─┬─┴─┬─┴─┬─┴─┬─┴─┬─┴─┬─┴─┬─┴─┬─┴─┬─┴─┬─────┼───┤
     * │     │   │   │   │   │   │Ins│   │   │   │   │PSc│Scr│Pause│   │
     * ├─────┴┬──┴┬──┴┬──┴┬──┴┬──┴┬──┴┬──┴┬──┴┬──┴┬──┴┬──┴┬──┴─────┼───┤
     * │      │   │   │   │   │   │   │   │   │   │   │   │        │   │
     * ├──────┴─┬─┴─┬─┴─┬─┴─┬─┴─┬─┴─┬─┴─┬─┴─┬─┴─┬─┴─┬─┴─┬─┴────┬───┼───┤
     * │        │   │   │   │   │   │   │Mut│Vl-│Vl+│   │      │   │   │
     * ├────┬───┴┬──┴─┬─┴───┴───┴───┴───┴───┴──┬┴──┬┴──┬┴──┬───┼───┼───┤
     * │    │    │    │                        │   │   │   │   │   │   │
     * └────┴────┴────┴────────────────────────┴───┴───┴───┴───┴───┴───┘
     */
    [1] = LAYOUT_65_custom(
        KC_GRV,  KC_F1,   KC_F2,   KC_F3,   KC_F4,   KC_F5,   KC_F6,   KC_F7,   KC_F8,   KC_F9,   KC_F10,  KC_F11,  KC_F12,  KC_DEL,
        _______, RM_TOGG, RM_NEXT, RM_PREV, RM_HUEU, RM_HUED, RM_SATU, RM_SATD, RM_VALU, RM_VALD, _______, _______, _______, QK_BOOT,
        _______, _______, _______, _______, _______, _______, _______, _______, _______, _______, _______,          _______, _______, KC_HOME,
        _______,          _______, _______, _______, _______, _______, _______, _______, _______, _______, _______, _______, KC_VOLU, KC_END,
        _______, _______, _______,                            KC_MPLY,                   _______, _______, _______, RM_HUEU, KC_VOLD, KC_MNXT,
        RM_TOGG
    ),
};

#if defined(ENCODER_MAP_ENABLE)
const uint16_t PROGMEM encoder_map[][NUM_ENCODERS][NUM_DIRECTIONS] = {
    [0] = { ENCODER_CCW_CW(KC_VOLD, KC_VOLU) },
    [1] = { ENCODER_CCW_CW(RM_VALD, RM_VALU) },
};
#endif
