ReuTheCoder/bolide-65-keeb/(commit log)

2026-10-16 rename pcb folder to improve repo orginization
    [bolide-65-pcb.kicad_pcb, bolide-65-pcb.kicad_sch, led_chain.kicad_sch, matrix.kicad_sch]
2026-10-16 rename flagship pcb image
2026-10-16 move gerbers file to more organized location
2026-10-16 add image for BOM
2026-10-16 add bom sheet
    [bom.csv]
2026-10-18 update pcb files w/ improved silkscreen
    [bolide-65-pcb.kicad_pcb]
2026-10-18 update gerbers
2026-10-19 Update README with better BOM
2026-10-22 Add CAD related files
    [CAD-Bottom Case.step, CAD-Middle Case.step, CAD-Rotary Encoder Knob.step, CAD-Top Plate.step]
2026-10-22 update bill of materials
    [bom.csv]
2026-10-22 Add alternative top plate files
    [bolide-65-top_plate.kicad_pcb, bolide-65-top_plate.kicad_sch]
2026-10-31 Add heavy keyboard assembly file using Git LFS
    [Keyboard_Assembly.step]
