ReuTheCoder/bolide-65-keeb/(notices)

Notices in the files:
pcb/bolide-65-pcb.kicad_pcb:
© Reuben O
